Staringlizard/memwa3/pcb/memwa3_back.PNG

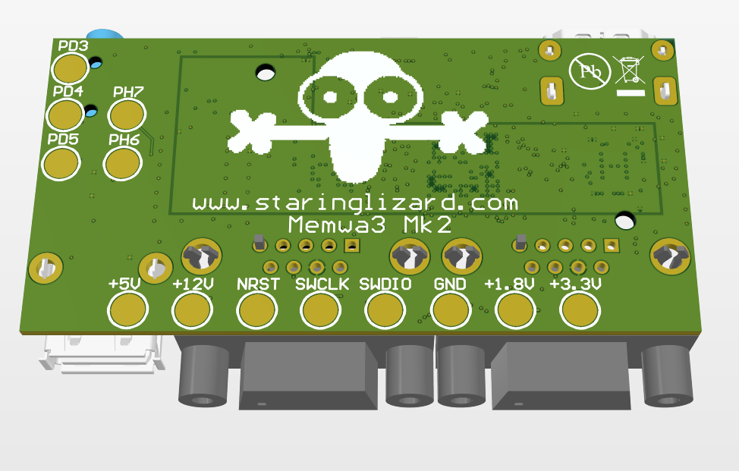
pcb/memwa3_back.PNG
