Staringlizard/memwa3/pcb/memwa3_front.PNG

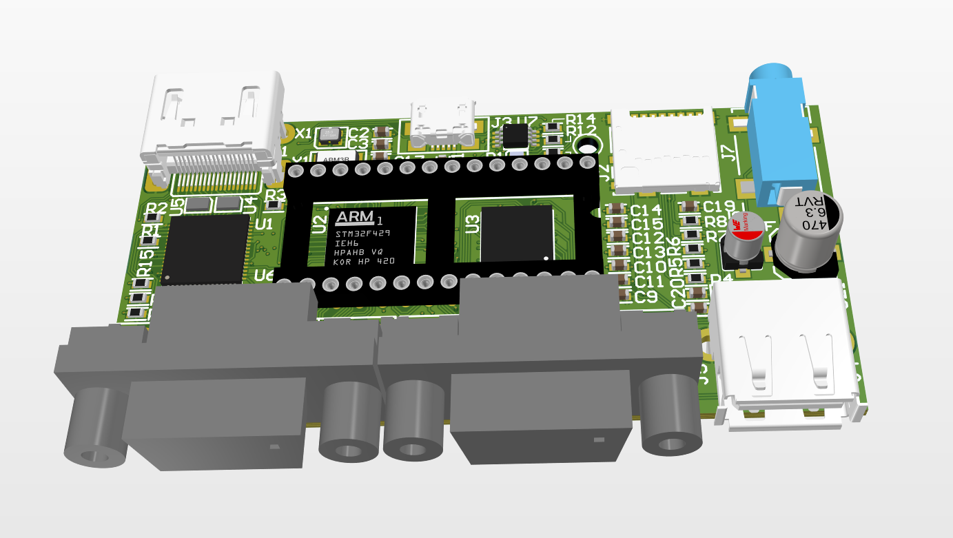
pcb/memwa3_front.PNG
