Staringlizard/memwa3/pcb/Memwa3_schematic.png

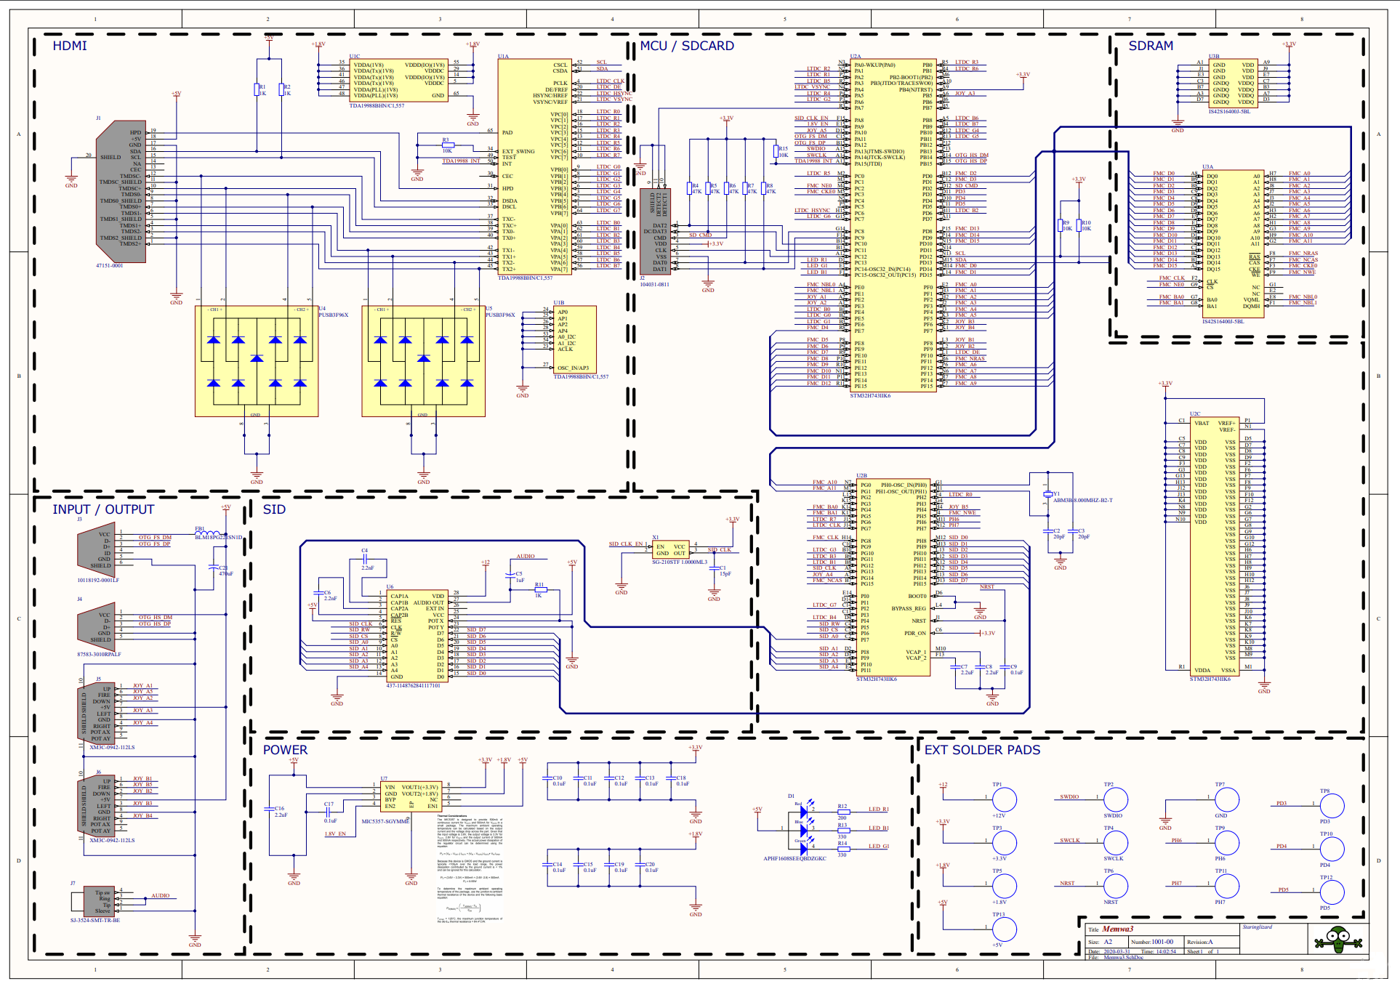
pcb/Memwa3_schematic.png
