Staringlizard/memwa3/pcb/Memwa3_schematic.pdf

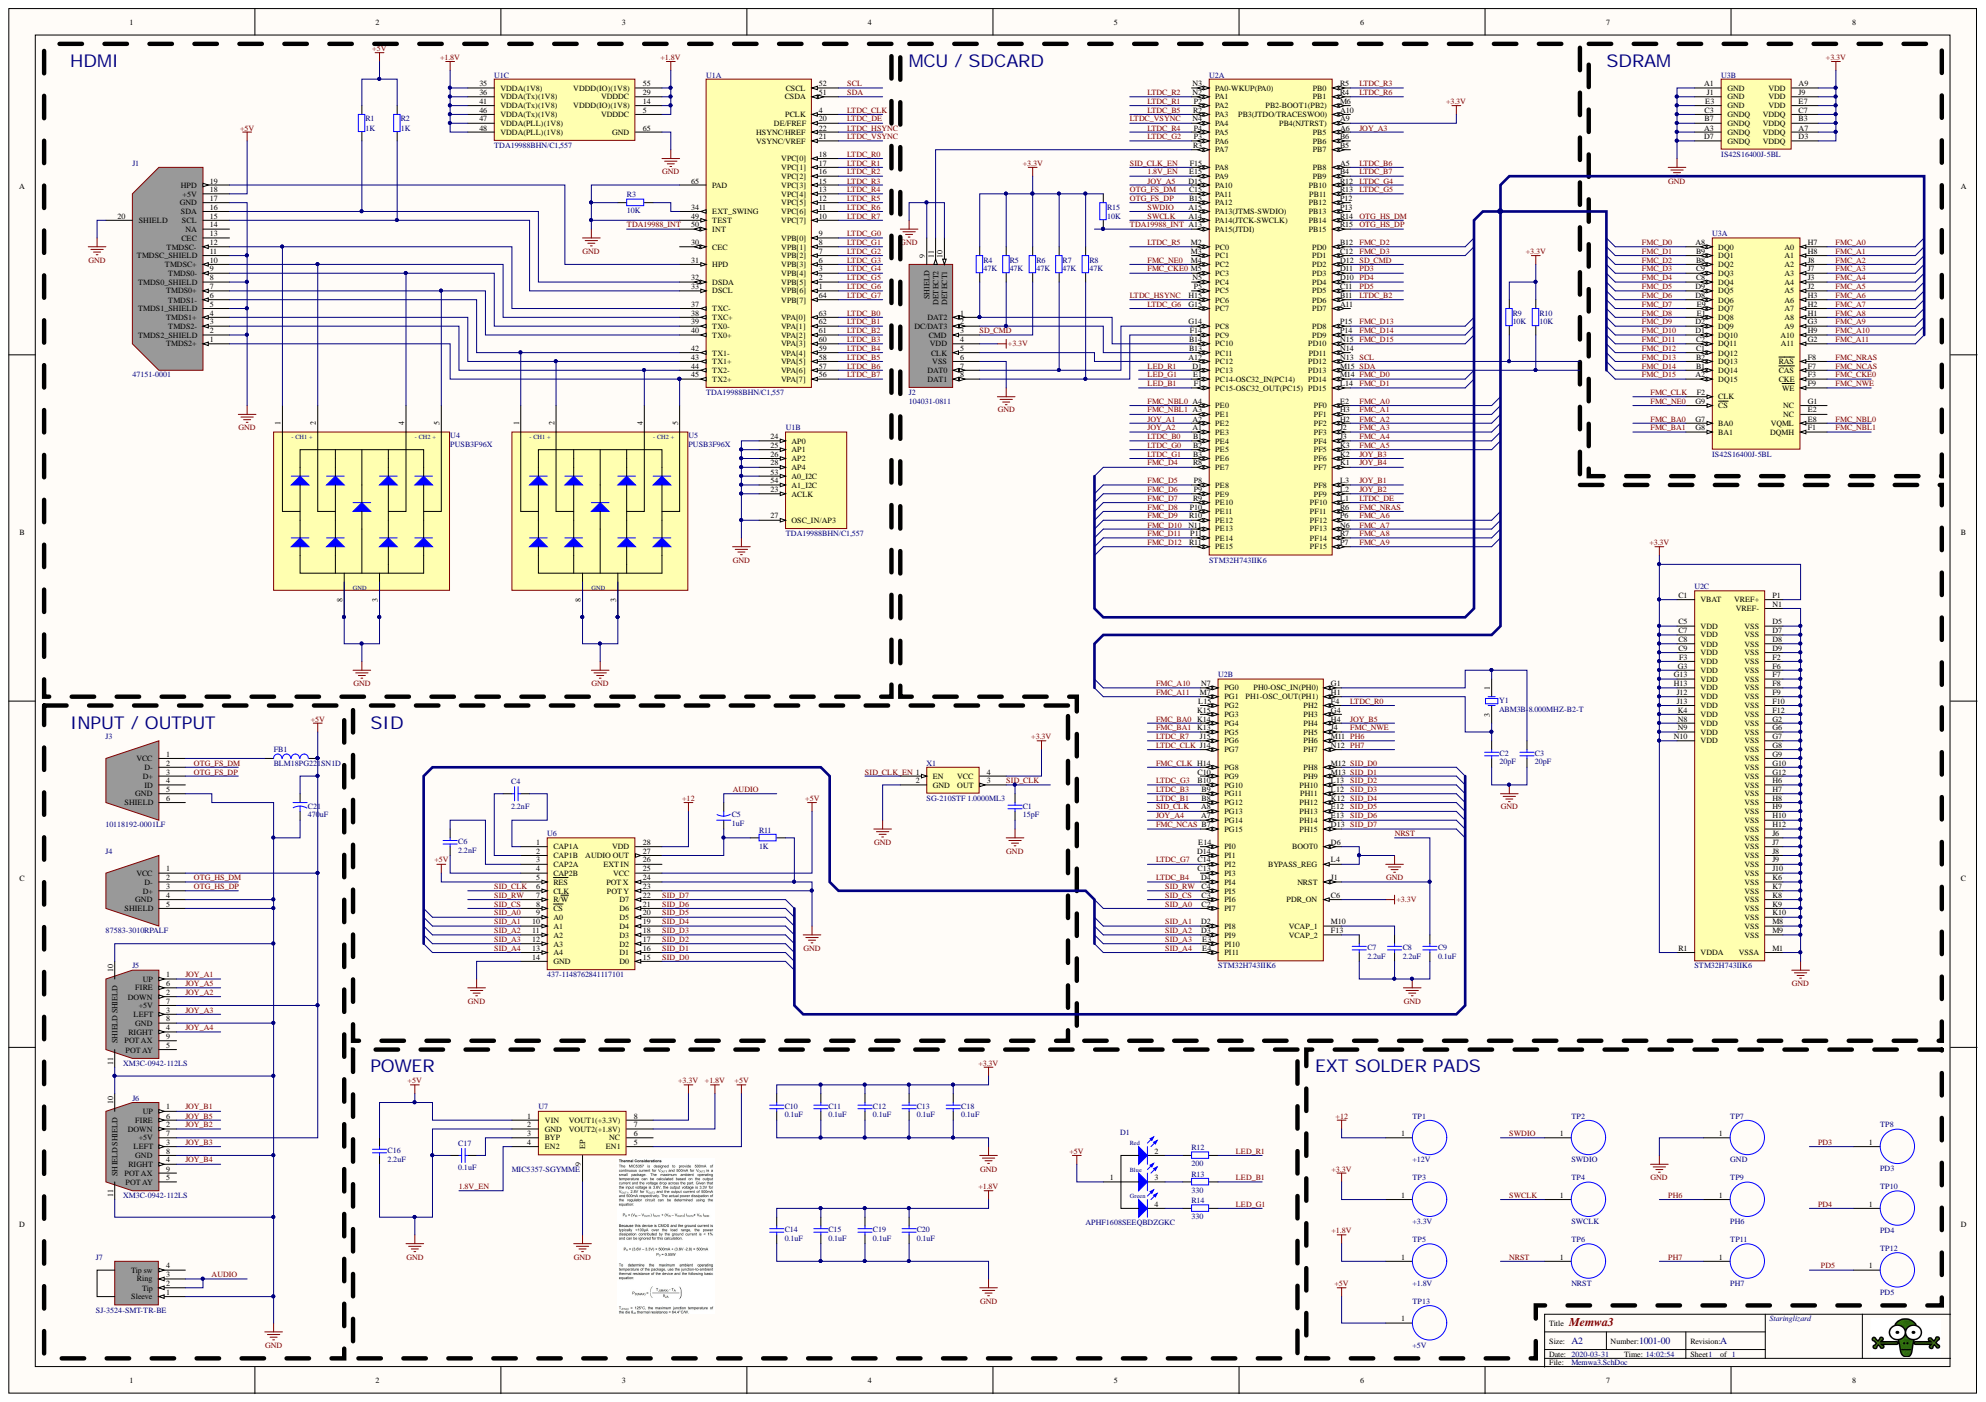
[picture p4: page 1]

LED_B1 | PC15-OSC32_OUT(PC15) F1

SJ-3524-SMT-TR-BE

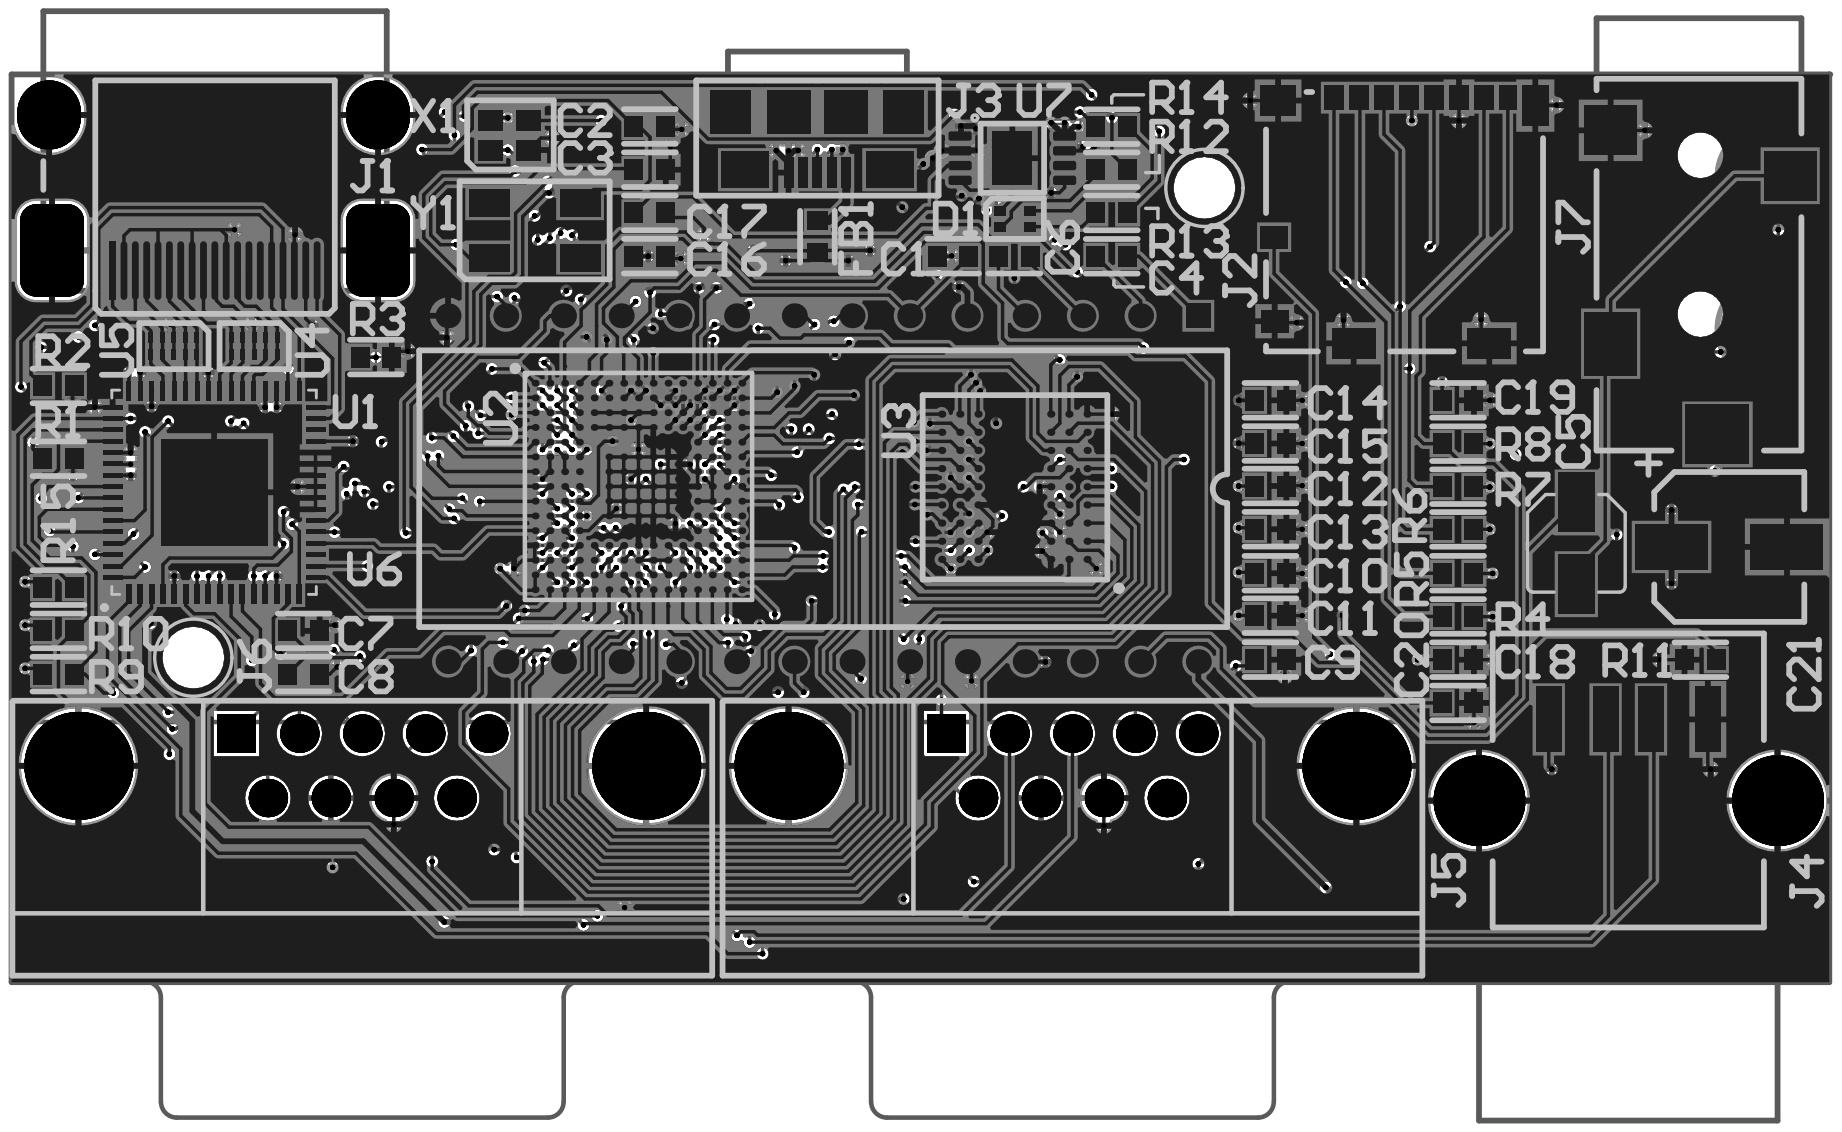
[picture p5: page 2]
