Staringlizard/memwa3/(commit log)

2018-12-05 Updated HAL and CMSIS to match stm32h7
2018-12-06 Added driver for rgb led and usb works!
2018-12-07 I2C working with tda19988!
2018-12-09 Fix led and some cleanup
    [main.c]
2018-12-09 Structure / design change
    [memwa2.stl]
2018-12-10 Fixed the terminal, printing function and cleaned up tda
    [drv_i2c.c, drv_i2c.h, hostif.c, irq.c]
2019-01-17 Cleanup and fixed problem with audio and keybd
    [diskio.c, drv_i2c.c, drv_ltdc.c, drv_sdcard.c, drv_sdcard.h, drv_sdram.c]
2019-01-18 Fixed diagnostics to be run at terminal
    [dev_tda19988.c, diag.c, diag.h, drv_sdcard.c, fsm.c, irq.c, main.c, serv_term.c]
